karna923/outdoor-autonomous-robot/CAD/E_plate_assem.SLDASM

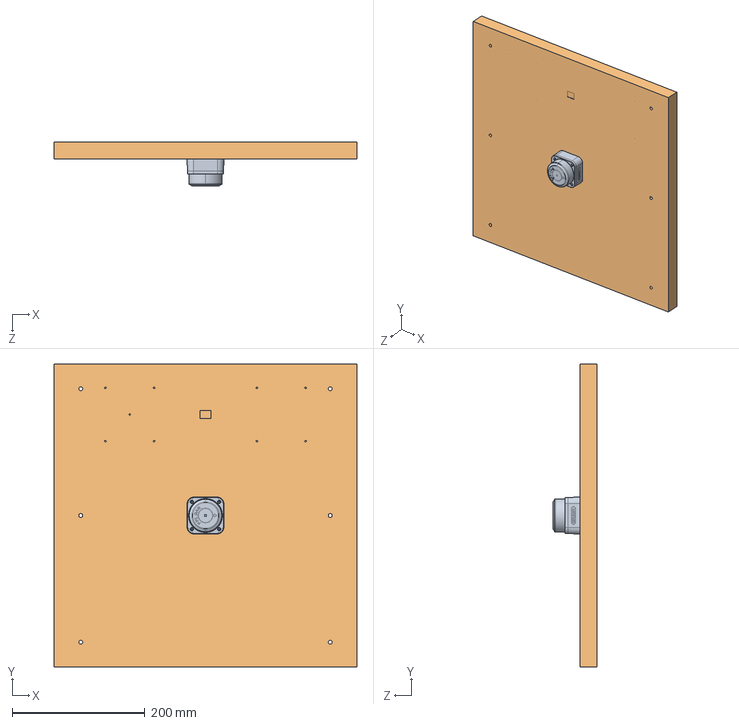
[picture p1: CAD file, 2026-05-29]
CAD/E_plate_assem.SLDASM
457.2 x 457.2 x 66.6 mm
ElecPlate
LIDAR
