karna923/outdoor-autonomous-robot/CAD/ElecPlate.SLDPRT

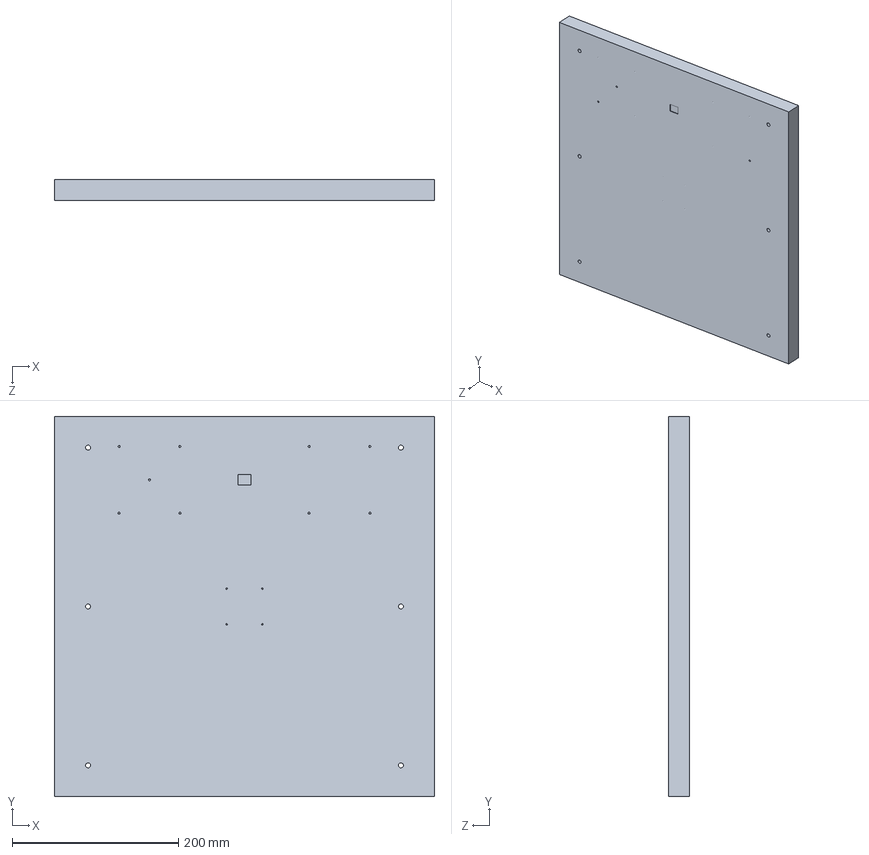
[picture p2: CAD file, 2026-05-29]
CAD/ElecPlate.SLDPRT
457.2 x 457.2 x 25.4 mm
