karna923/outdoor-autonomous-robot/CAD/LIDAR.SLDPRT

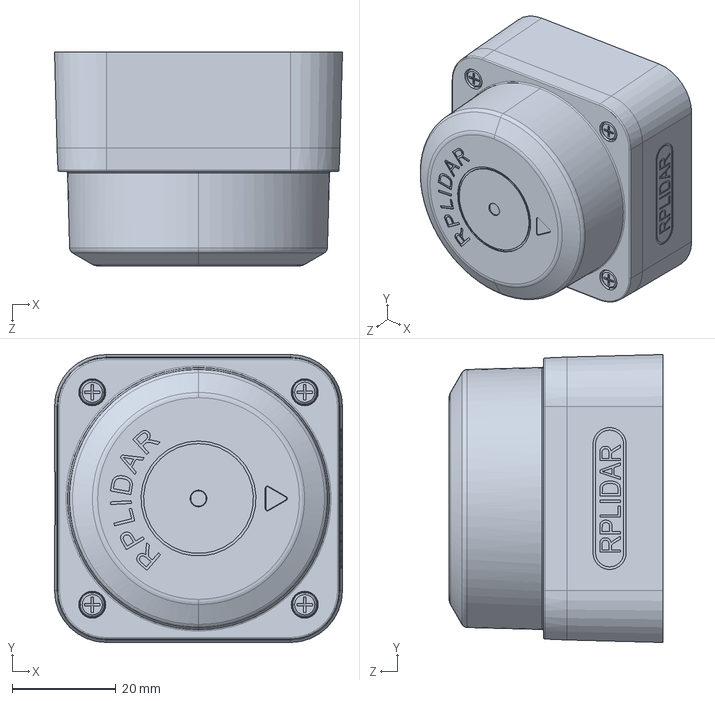
[picture p3: CAD file, 2026-05-29]
CAD/LIDAR.SLDPRT
55.6 x 55.6 x 41.3 mm
