karna923/outdoor-autonomous-robot/CAD/chassis_plate.SLDPRT

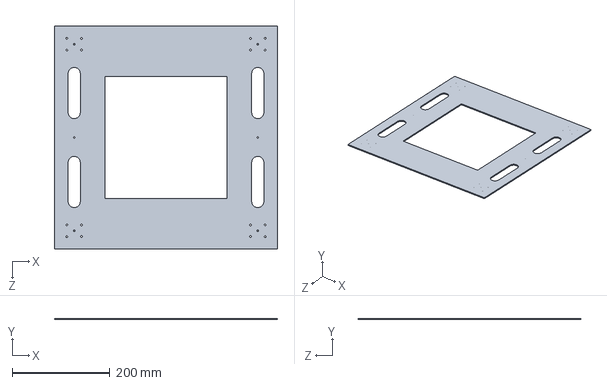
[picture p4: CAD file, 2026-05-20]
CAD/chassis_plate.SLDPRT
457.2 x 3.00 x 457.2 mm
