karna923/outdoor-autonomous-robot/(list of files, cad)

Other CAD files:
CAD/GPS_Mount_v1.SLDPRT
