karna923/outdoor-autonomous-robot/ROVERSCHEM/outdoor_autonomous_rover_main.kicad_sch

## KiCad design ROVERSCHEM/outdoor_autonomous_rover_main.kicad_sch (2026-06-18)

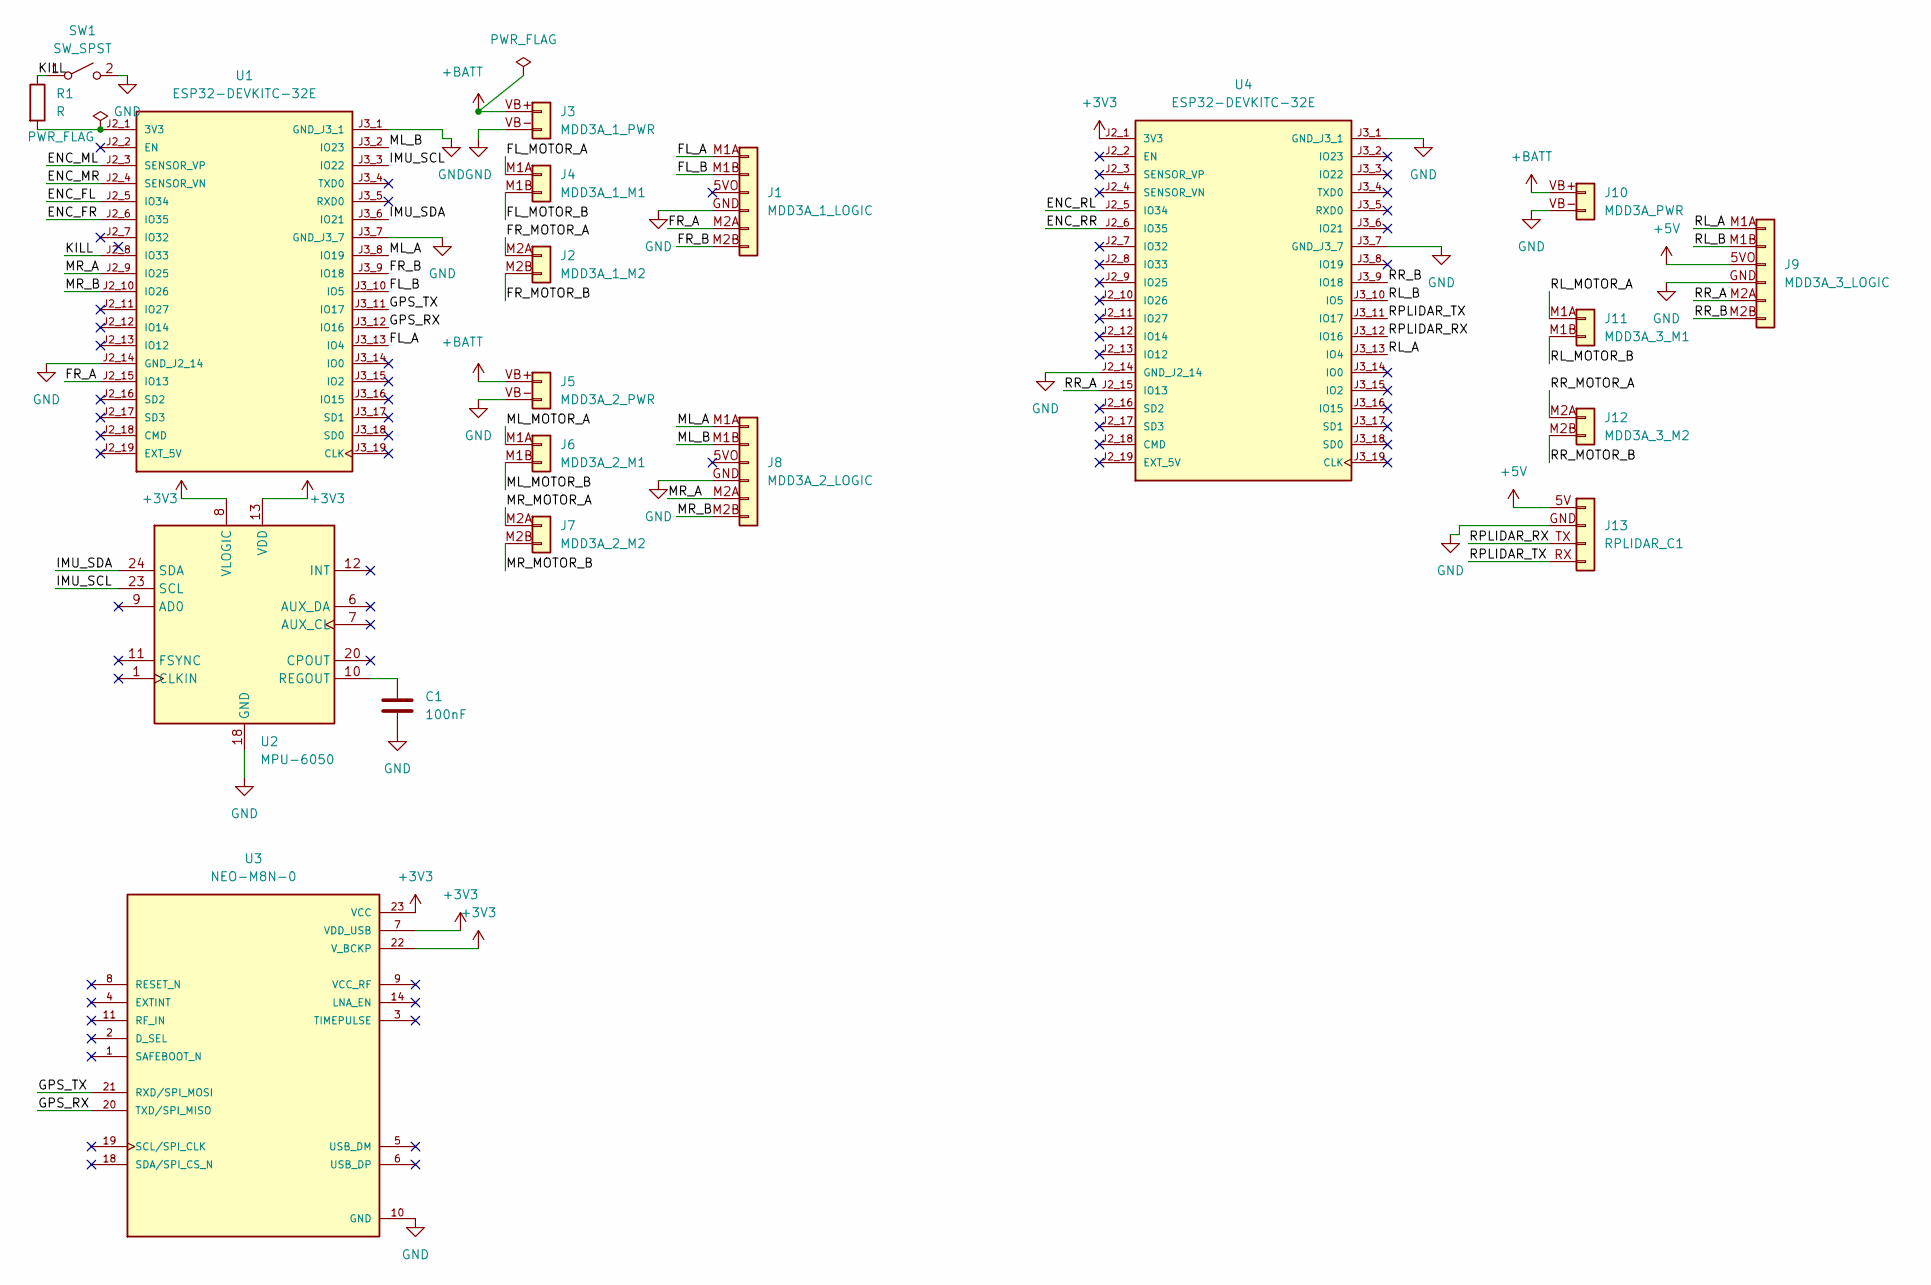
[picture p5: schematic outdoor_autonomous_rover_main.kicad_sch]

Parts:
C1: 100nF
J1: MDD3A_1_LOGIC
J2: MDD3A_1_M2
J3: MDD3A_1_PWR
J4: MDD3A_1_M1
J5: MDD3A_2_PWR
J6: MDD3A_2_M1
J7: MDD3A_2_M2
J8: MDD3A_2_LOGIC
J9: MDD3A_3_LOGIC
J10: MDD3A_PWR
J11: MDD3A_3_M1
J12: MDD3A_3_M2
J13: RPLIDAR_C1
R1: R
SW1: SW_SPST
U1, U4: ESP32-DEVKITC-32E; MODULE_ESP32-DEVKITC-32E; PARTREV 1.4
U2: MPU-6050; InvenSense_QFN-24_4x4mm_P0.5mm
U3: NEO-M8N-0; XCVR_NEO-M8N-0; PARTREV R04

Connections:
+3V3: U2.8 (VLOGIC), U2.13 (VDD), U3.7 (VDD_USB), U3.22 (V_BCKP), U3.23 (VCC), U4.J2_1 (3V3)
+5V: J9.5VO (Pin_3), J13.5V (Pin_1)
+BATT: J3.VB+, J5.VB+, J10.VB+ (Pin_1)
ENC_FL: U1.J2_5 (IO34)
ENC_FR: U1.J2_6 (IO35)
ENC_ML: U1.J2_3 (SENSOR_VP)
ENC_MR: U1.J2_4 (SENSOR_VN)
ENC_RL: U4.J2_5 (IO34)
ENC_RR: U4.J2_6 (IO35)
FL_A: J1.M1A (Pin_1), U1.J3_13 (IO4)
FL_B: J1.M1B (Pin_2), U1.J3_10 (IO5)
FL_MOTOR_A: J4.M1A
FL_MOTOR_B: J4.M1B
FR_A: J1.M2A (Pin_5), U1.J2_15 (IO13)
FR_B: J1.M2B (Pin_6), U1.J3_9 (IO18)
FR_MOTOR_A: J2.M2A
FR_MOTOR_B: J2.M2B
GND: C1.2, J1.GND (Pin_4), J3.VB-, J5.VB-, J8.GND (Pin_4), J9.GND (Pin_4), J10.VB- (Pin_2), J13.GND (Pin_2), SW1.2 (B), U1.J2_14 (GND_J2_14), U1.J3_1 (GND_J3_1), U1.J3_7 (GND_J3_7), U2.18 (GND), U3.10 (GND), U3.12 (GND), U3.13 (GND), U3.24 (GND), U4.J2_14 (GND_J2_14), U4.J3_1 (GND_J3_1), U4.J3_7 (GND_J3_7)
GPS_RX: U1.J3_12 (IO16), U3.20 (TXD/SPI_MISO)
GPS_TX: U1.J3_11 (IO17), U3.21 (RXD/SPI_MOSI)
IMU_SCL: U1.J3_3 (IO22), U2.23 (SCL)
IMU_SDA: U1.J3_6 (IO21), U2.24 (SDA)
KILL: R1.1, SW1.1 (A), U1.J2_8 (IO33)
ML_A: J8.M1A (Pin_1), U1.J3_8 (IO19)
ML_B: J8.M1B (Pin_2), U1.J3_2 (IO23)
ML_MOTOR_A: J6.M1A
ML_MOTOR_B: J6.M1B
MR_A: J8.M2A (Pin_5), U1.J2_9 (IO25)
MR_B: J8.M2B (Pin_6), U1.J2_10 (IO26)
MR_MOTOR_A: J7.M2A
MR_MOTOR_B: J7.M2B
unnamed: C1.1, U2.10 (REGOUT)
unnamed: R1.2, U1.J2_1 (3V3)
RL_A: J9.M1A (Pin_1), U4.J3_13 (IO4)
RL_B: J9.M1B (Pin_2), U4.J3_10 (IO5)
RL_MOTOR_A: J11.M1A (Pin_1)
RL_MOTOR_B: J11.M1B (Pin_2)
RPLIDAR_RX: J13.TX (Pin_3), U4.J3_12 (IO16)
RPLIDAR_TX: J13.RX (Pin_4), U4.J3_11 (IO17)
RR_A: J9.M2A (Pin_5), U4.J2_15 (IO13)
RR_B: J9.M2B (Pin_6), U4.J3_9 (IO18)
RR_MOTOR_A: J12.M2A (Pin_1)
RR_MOTOR_B: J12.M2B (Pin_2)
