karna923/outdoor-autonomous-robot/ROVERSCHEM/untitled.kicad_sch

## KiCad design ROVERSCHEM/untitled.kicad_sch (2026-06-18)

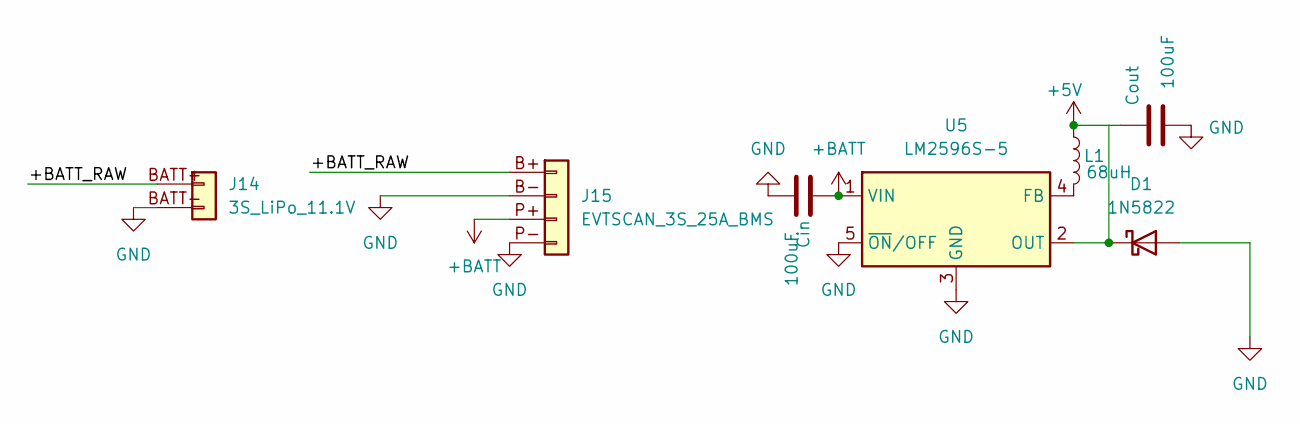
[picture p6: schematic untitled.kicad_sch]

Parts:
Cin: 100uF
Cout: 100uF
D1: 1N5822
J14: 3S_LiPo_11.1V
J15: EVTSCAN_3S_25A_BMS
L1: 68uH
U5: LM2596S-5; TO-263-5_TabPin3

Connections:
+5V: Cout.1, L1.1
+BATT: Cin.1, J15.P+ (Pin_3), U5.1 (VIN)
+BATT_RAW: J14.BATT+ (Pin_1), J15.B+ (Pin_1)
GND: Cin.2, Cout.2, D1.2 (A), J14.BATT- (Pin_2), J15.B- (Pin_2), J15.P- (Pin_4), U5.3 (GND), U5.5 (~ON/OFF)
unnamed: D1.1 (K), U5.2 (OUT)
unnamed: L1.2, U5.4 (FB)
