karna923/outdoor-autonomous-robot/firmware/esp32_2/main/pins_esp2.hpp

#ifndef PINS_ESP2_HPP
#define PINS_ESP2_HPP

//MDD3A #3 - REAR motors
//Motor 5 (rear left)
#define MOTOR_RL_A 4
#define MOTOR_RL_B 5

//Motor 6 (rear right)
#define MOTOR_RR_A 13
#define MOTOR_RR_B 18

//Encoders
#define ENC_RL 34
#define ENC_RR 35

//HC-SR04 ultrasonic
#define ULTRASONIC_TRIG 17
#define ULTRASONIC_ECHO 16

//SG90 servo
#define SERVO_PWM 19

#endif
