karna923/outdoor-autonomous-robot/(commit log)

2026-05-12 feat: add motor_controller and odometry_publisher nodes
2026-05-12 feat: add Docker compose — micro-ROS agent + ROS 2 stack
2026-05-13 feat(firmware): add GPIO pin definitions for MDD3A, encoders, IMU, GPS
2026-05-13 feat(firmware): add Motor class with LEDC PWM control for Cytron MDD3A
2026-05-29 Add files via upload
    CAD files - More to come!
    [E_plate_assem.SLDASM, GPS_Mount_v1.SLDPRT, LIDAR.SLDPRT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]
2026-06-10 refactor: split pins into esp1/esp2, fix LEDC timer init
    [motor_control.cpp, motor_control.hpp, pins_esp1.hpp, pins_esp2.hpp, robot_firmware.cpp]
2026-06-10 feat: instantiate 4 motors on ESP32 #1 with correct LEDC channels
    [robot_firmware.cpp]
2026-06-10 feat: add encoder ISRs and GPIO interrupt setup for ESP32 #1
2026-06-10 feat: encoder ISRs, GPIO interrupt setup, motor init order fixed
    [motor_control.cpp, robot_firmware.cpp]
2026-06-10 feat: PID implementation with compute() and setPID()
2026-06-10 feat: control task with velocity computation and PID loop
2026-06-10 add esp32_2 firmware, fix build environment and IntelliSense config
    [motor_control.cpp, motor_control.hpp, pins_esp1.hpp, pins_esp2.hpp, robot_firmware.cpp]
2026-06-11 add esp32_2 lidar bridge config, gitignore wifi credentials
2026-06-11 esp32_2: add WiFi station init, UART-UDP lidar bridge tasks
2026-06-12 fix volatile compound assignment warnings in encoder ISRs
    [robot_firmware.cpp]
2026-06-12 feat: ESP32 #1 firmware builds successfully with micro-ROS
    - libmicroros.a built (1701 obj files) via espressif/idf:release-v5.3 Docker
    - Fixed toolchain: C_STANDARD=99, custom transport, RMW_UXRCE_TRANSPORT=custom
    - Flattened include/include/ for idf.py build compatibility
    - robot_firmware.bin builds clean, 27% flash free
    [robot_firmware.cpp]
2026-06-16 feat: add IMU reads (MPU-6050 I2C) and publish to /imu
2026-06-16 feat: add GPS reads (ATGM336H NMEA UART) and publish to /gps
2026-06-16 feat: add URDF, robot_state_publisher to bringup launch
    [robot.urdf.xacro]
2026-06-18 Schematic added
    [outdoor_autonomous_rover_main.kicad_sch, untitled.kicad_sch]
2026-06-18 feat: complete ESP32 #1/#2 KiCad schematics, nav2/slam/ekf config
    - KiCad schematic: ESP32 #1 (FL/FR/ML/MR motors, MPU-6050 IMU, NEO-M8N GPS, kill switch)
    - KiCad schematic: ESP32 #2 (RL/RR motors, RPLidar C1 bridge)
    - KiCad schematic: power distribution (LiPo -> BMS -> LM2596S-5 -> 5V)
    - bringup.launch.py: added slam_toolbox and Nav2 launches
    - slam_toolbox.yaml: new config, 5cm resolution, 12m lidar range
    - nav2_params.yaml: polygon footprint, tuned velocities/lookahead for rover dimensions
    - ekf.yaml: added GPS pose0 fusion, rejection threshold
    - navsat_transform.yaml: Collierville TN declination 0.01152 rad
2026-06-18 urdf: update dimensions from CAD, correct inertia tensor for 8.5kg chassis
    [robot.urdf.xacro]
2026-06-20 update chassis dims, inertia, and nav2 footprint to scaled chassis
    [robot.urdf.xacro]
2026-06-28 ESP32 #2 micro-ROS rewrite: ultrasonic+servo publisher, reactive obstacle avoidance node, remove slam_toolbox, update nav2 costmap, remap cmd_vel_safe
    [motor_controller.cpp, pins_esp2.hpp, robot_firmware.cpp]
2026-07-03 Fix wheel/motor odometry constants, add 4-wheel toggle, point submodules at forked fixes
    [robot_firmware.cpp]
